dinvincible98/MAE106/README.md

# MAE106

This is the final project for MAE106 Mechancial Systems Laboratory. For more detailed information regarding mechanical, electrical, and code section, please view the final report.
