dinvincible98/MAE106/Code/src/mpu.h

#ifndef MPU_H
#define MPU_H

struct s_mympu {
	float ypr[3];
	float yprd[3];
	float gyro[3];
	float heading;
};

extern struct s_mympu mympu;

int mympu_open(unsigned int rate);
int mympu_update();

#endif
